revk/ESP32-Gyro/PCB/Gyro/README.md

# Gyro

These files are for use in [KiCad](https://www.kicad.org).

## Trademark

This is an open source project, but bear in mind you cannot sell boards bearing the Andrews & Arnold Ltd name, the A&A logo, the registered trademark AJK logo, or the GS1 allocated EANs assigned to Andrews & Arnold Ltd.

## Images

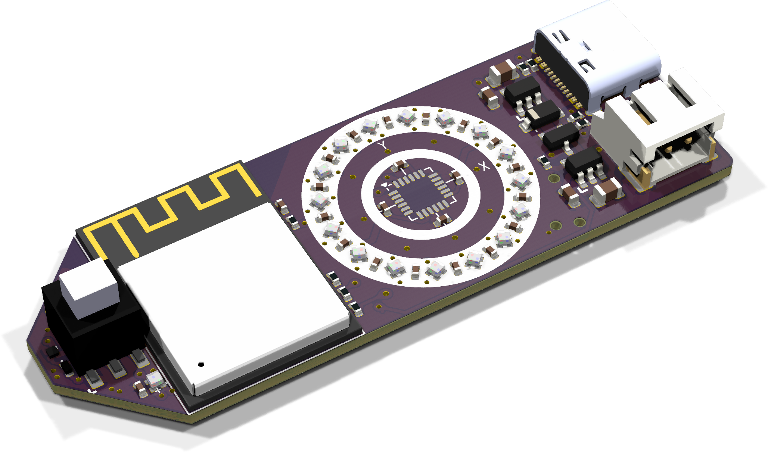
[picture p1: PCB/Gyro/Gyro.png]
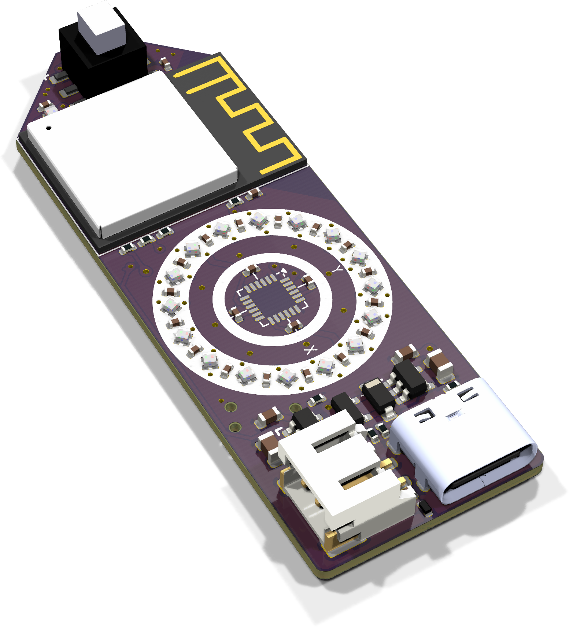
[picture p2: PCB/Gyro/Gyro-90.png]
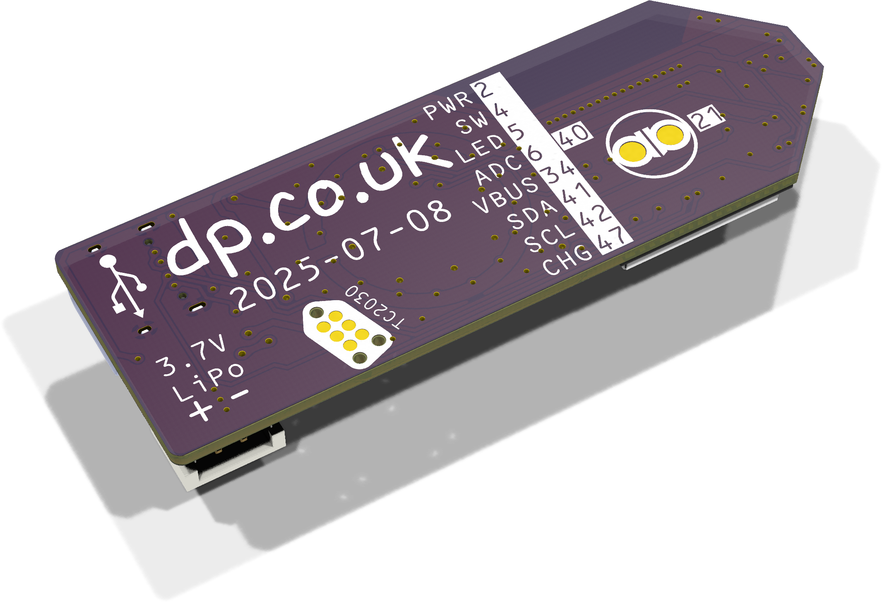
[picture p3: PCB/Gyro/Gyro-bottom.png]

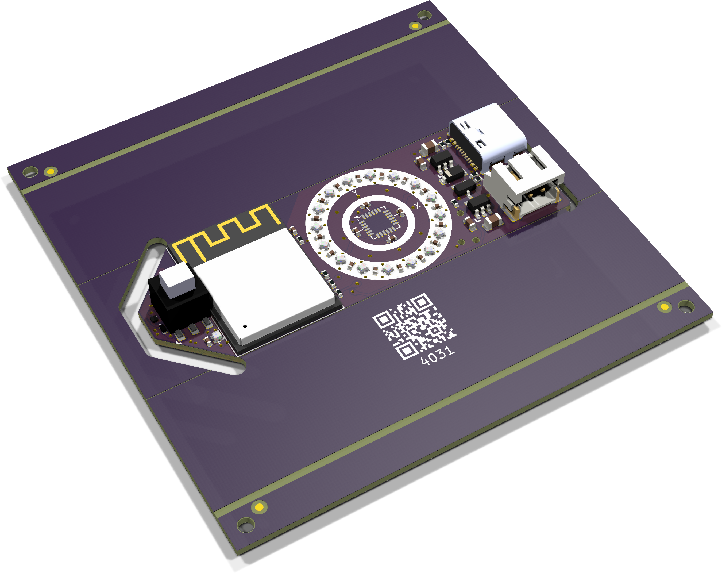
[picture p4: PCB/Gyro/Gyro-panel.png]
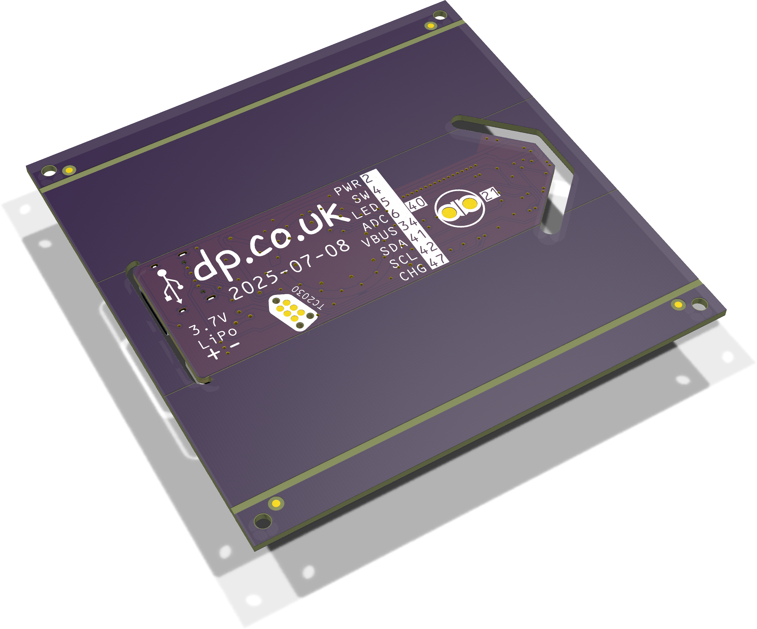
[picture p5: PCB/Gyro/Gyro-panel-bottom.png]


*Auto generated 2025-07-08T09:44:21*
