revk/ESP32-Gyro/PCB/Gyro/Gyro.stl

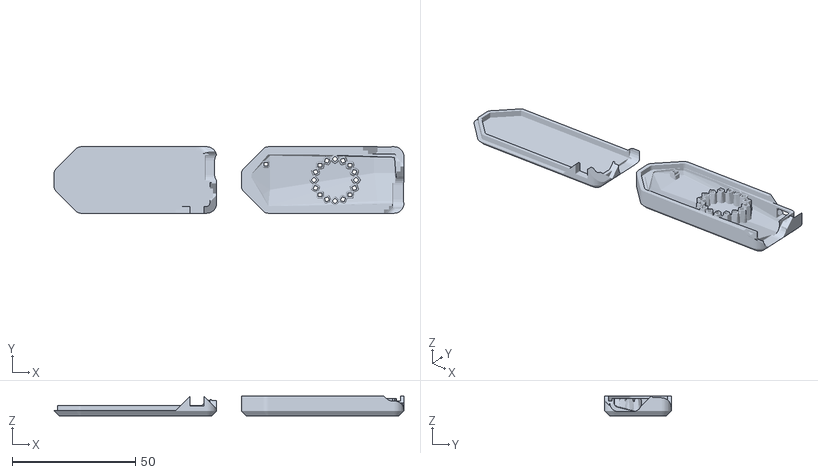
[picture p6: CAD file, 2025-07-08]
PCB/Gyro/Gyro.stl
142.0 x 27.0 x 8.00
