revk/ESP32-Gyro/PCB/Gyro/Gyro.kicad_pcb

## KiCad design PCB/Gyro/Gyro.kicad_pcb (2025-07-08)

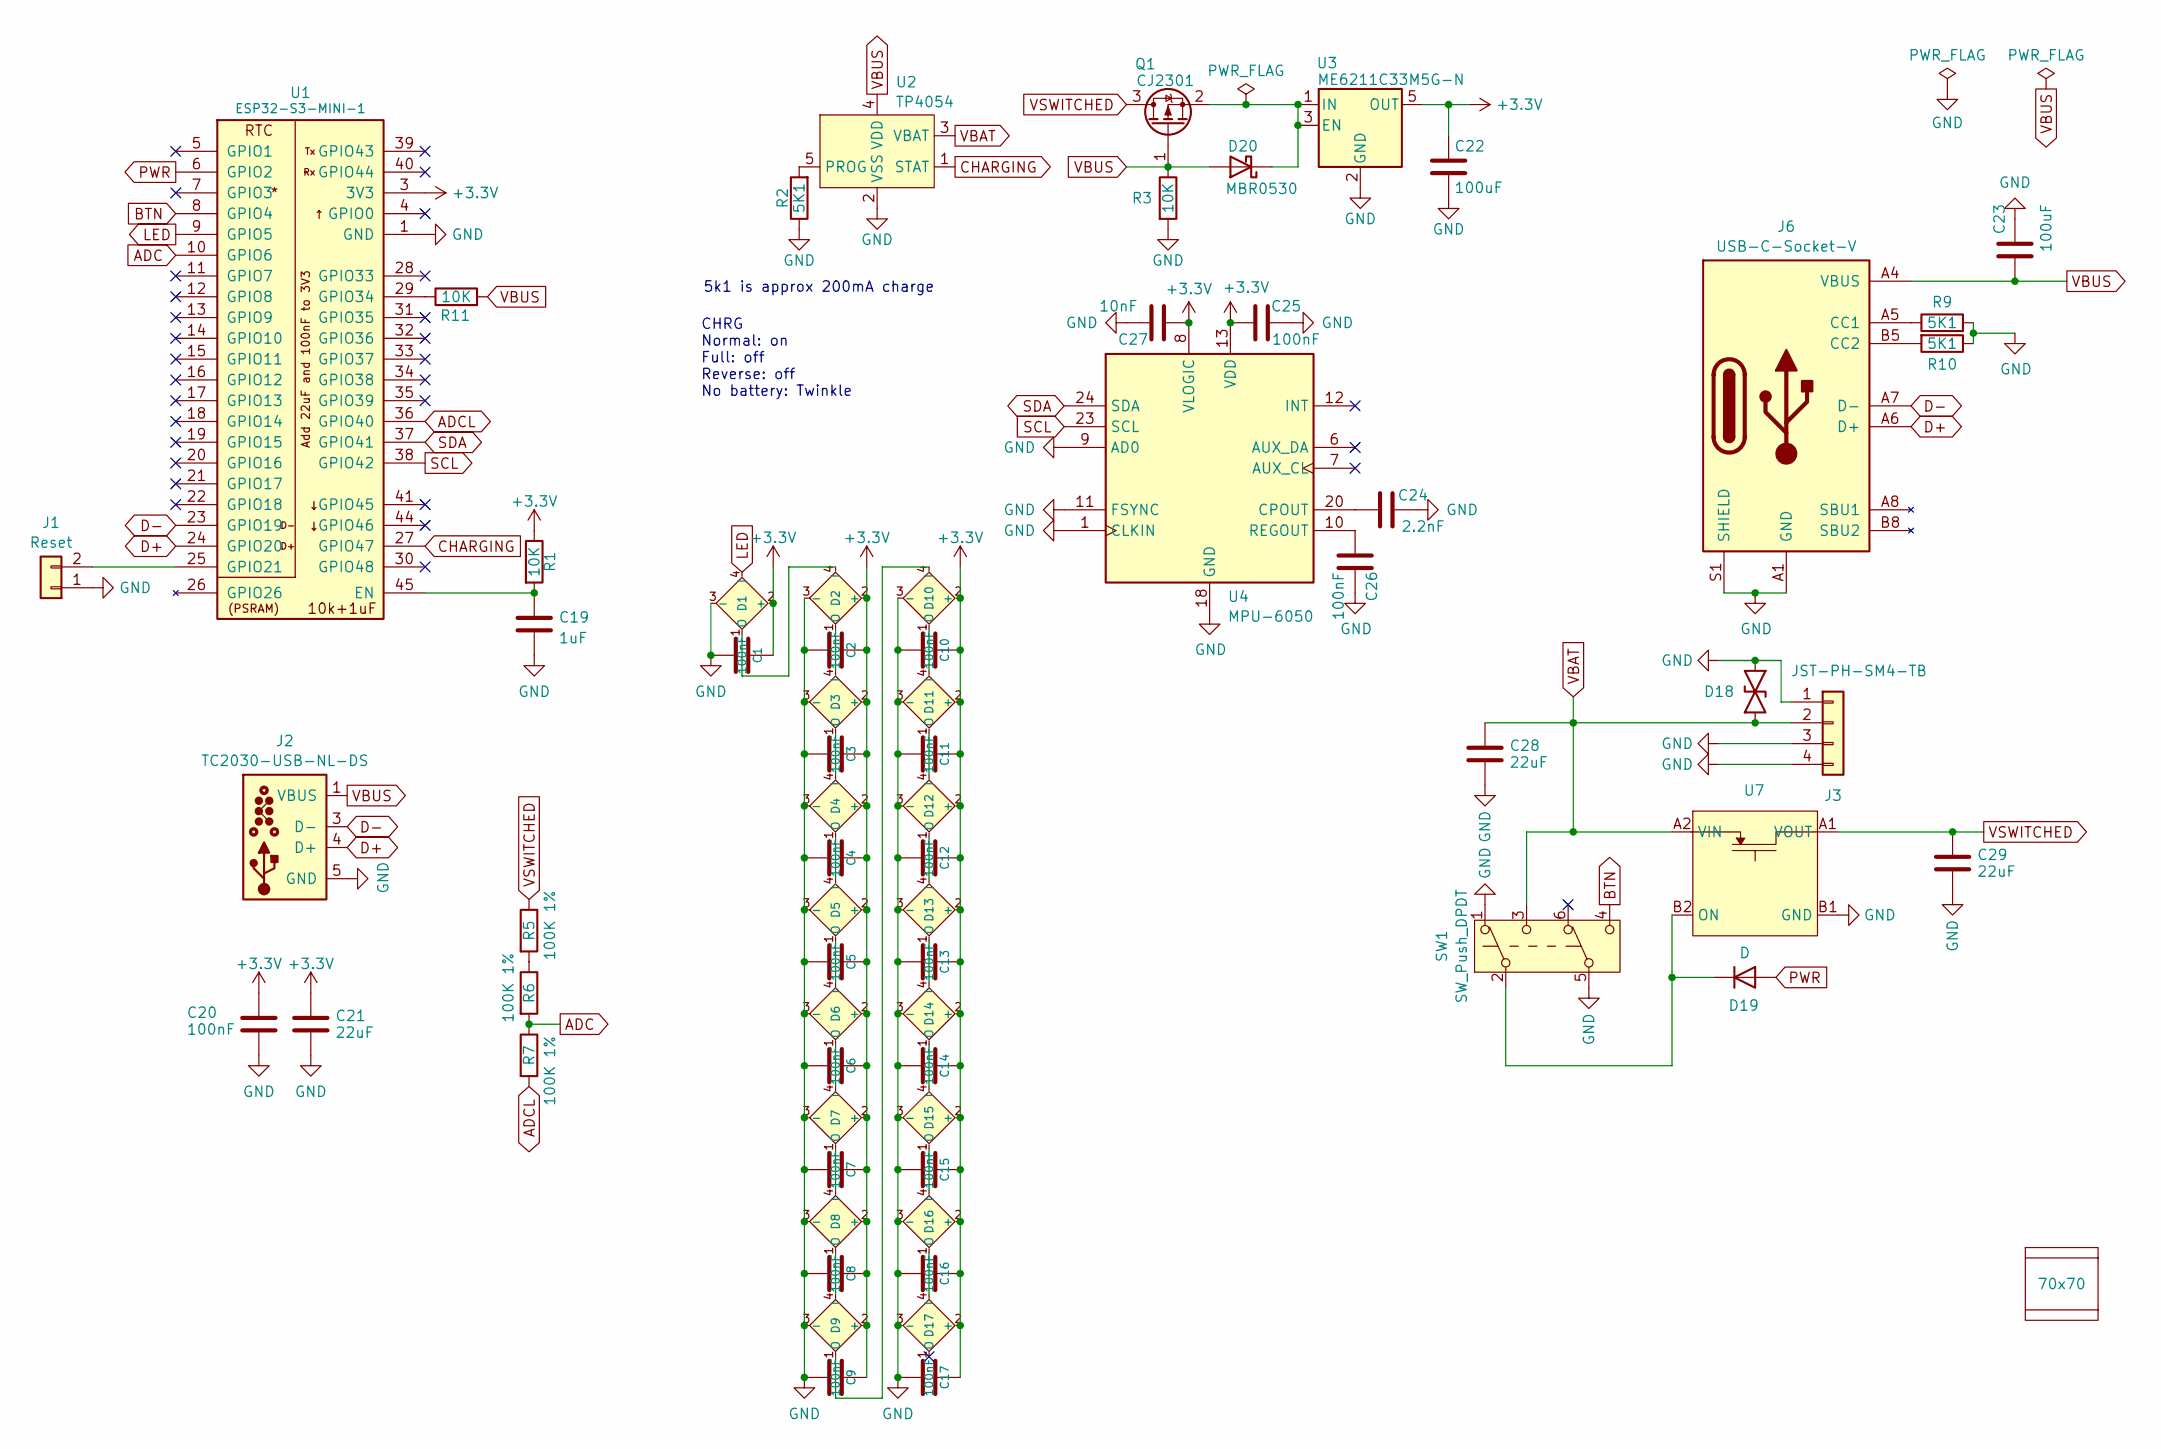
[picture p7: schematic Gyro.kicad_sch]

Parts:
C1, C2, C3, C4, C5, C6, C7, C8, C9, C10, C11, C12, C13, C14, C15, C16, C17, C20, C25, C26: 100nF; C_0402
C19: 1uF; C_0402
C21, C28, C29: 22uF; C_0603
C22, C23: 100uF; C_0805; MPN C141660
C24: 2.2nF; C_0402
C27: 10nF; C_0402
D1, D2, D3, D4, D5, D6, D7, D8, D9, D10, D11, D12, D13, D14, D15, D16, D17: XL-1010RGBC-WS2812B; SMD1010; MPN C5349953
D18: DFN1006-2L; MPN C5137770
D19: D; D_0402; MPN C28642302
D20: MBR0530; D_SOD-123; MPN C5204746
J1: Reset; AA-Pad
J2: TC2030-USB-NL-DS; Tag-Connect_TC2030-IDC-NL_2x03_P1.27mm_Vertical
J3: JST-PH-SM4-TB; JST_PH_S2B-PH-SM4-TB_1x02-1MP_P2.00mm_Horizontal; MPN C295747
J6: USB-C-Socket-V; USB-C-Socket-H; MPN C709357
PCB1: 70x70; PCB7070
Q1: CJ2301; SOT-23; MPN C8547
R1, R3, R11: 10K; R_0402; MPN C25744
R2, R9, R10: 5K1; R_0402; MPN C25905
R5, R6, R7: 100K 1%; R_0402; MPN C5139597
SW1: SW_Push_DPDT; MPN C2911139
U1: ESP32-S3-MINI-1; MPN C3013941
U2: TP4054; SOT-23-5; MPN C668215
U3: ME6211C33M5G-N; SOT-23-5; MPN C82942
U4: MPU-6050; InvenSense_QFN-24_4x4mm_P0.5mm; MPN C24112
U7: WCSP-4-0.78x0.78; MPN C2655476
V1, V2: VCUT70N

Connections:
+3.3V: C1.1, C2.1, C3.1, C4.1, C5.1, C6.1, C7.1, C8.1, C9.1, C10.1, C11.1, C12.1, C13.1, C14.1, C15.1, C16.1, C17.1, C20.1, C21.1, C22.1, C25.1, C27.1, D1.2 (+), D2.2 (+), D3.2 (+), D4.2 (+), D5.2 (+), D6.2 (+), D7.2 (+), D8.2 (+), D9.2 (+), D10.2 (+), D11.2 (+), D12.2 (+), D13.2 (+), D14.2 (+), D15.2 (+), D16.2 (+), D17.2 (+), R1.1, U1.3 (3V3), U3.5 (OUT), U4.8 (VLOGIC), U4.13 (VDD)
ADC: R6.2, R7.1, U1.10 (GPIO6)
ADCL: R7.2, U1.36 (GPIO40)
BTN: SW1.4 (C), U1.8 (GPIO4)
CHARGING: U1.27 (GPIO47), U2.1 (STAT)
D+: J2.4 (D+), J6.A6 (D+), J6.B6 (D+), U1.24 (GPIO20)
D-: J2.2 (NC), J2.3 (D-), J2.6 (NC), J6.A7 (D-), J6.B7 (D-), U1.23 (GPIO19)
GND: C1.2, C2.2, C3.2, C4.2, C5.2, C6.2, C7.2, C8.2, C9.2, C10.2, C11.2, C12.2, C13.2, C14.2, C15.2, C16.2, C17.2, C19.2, C20.2, C21.2, C22.2, C23.2, C24.2, C25.2, C26.2, C27.2, C28.2, C29.2, D1.3 (-), D2.3 (-), D3.3 (-), D4.3 (-), D5.3 (-), D6.3 (-), D7.3 (-), D8.3 (-), D9.3 (-), D10.3 (-), D11.3 (-), D12.3 (-), D13.3 (-), D14.3 (-), D15.3 (-), D16.3 (-), D17.3 (-), D18.1, J1.1, J2.5 (GND), J3.1, J3.3, J3.4, J6.A1 (GND), J6.A12 (GND), J6.B1 (GND), J6.B12 (GND), J6.S1 (SHIELD), R2.1, R3.2, R9.2, R10.1, SW1.1 (A), SW1.5 (B), U1.1 (GND), U1.2 (GND), U1.42 (GND), U1.43 (GND), U1.46 (GND), U1.47 (GND), U1.48 (GND), U1.49 (GND), U1.50 (GND), U1.51 (GND), U1.52 (GND), U1.53 (GND), U1.54 (GND), U1.55 (GND), U1.56 (GND), U1.57 (GND), U1.58 (GND), U1.59 (GND), U1.60 (GND), U1.61 (GND), U1.62 (GND), U1.63 (GND), U1.64 (GND), U1.65 (GND), U2.2 (VSS), U3.2 (GND), U4.1 (CLKIN), U4.9 (AD0), U4.11 (FSYNC), U4.18 (GND), U7.B1 (GND)
LED: D1.4 (I), U1.9 (GPIO5)
unnamed: D1.1 (O), D2.4 (I)
unnamed: D2.1 (O), D3.4 (I)
unnamed: D3.1 (O), D4.4 (I)
unnamed: D4.1 (O), D5.4 (I)
unnamed: D5.1 (O), D6.4 (I)
unnamed: D6.1 (O), D7.4 (I)
unnamed: D7.1 (O), D8.4 (I)
unnamed: D8.1 (O), D9.4 (I)
unnamed: D9.1 (O), D10.4 (I)
unnamed: D10.1 (O), D11.4 (I)
unnamed: D11.1 (O), D12.4 (I)
unnamed: D12.1 (O), D13.4 (I)
unnamed: D13.1 (O), D14.4 (I)
unnamed: D14.1 (O), D15.4 (I)
unnamed: D15.1 (O), D16.4 (I)
unnamed: D16.1 (O), D17.4 (I)
unnamed: D19.1 (K), SW1.2 (B), U7.B2 (ON)
unnamed: D20.1 (K), Q1.2 (S), U3.1 (IN), U3.3 (EN)
unnamed: J1.2, U1.25 (GPIO21)
unnamed: J6.A5 (CC1), R9.1
unnamed: J6.B5 (CC2), R10.2
unnamed: R5.2, R6.1
unnamed: C19.1, R1.2, U1.45 (EN)
unnamed: R11.1, U1.29 (GPIO34)
unnamed: R2.2, U2.5 (PROG)
unnamed: C24.1, U4.20 (CPOUT)
unnamed: C26.1, U4.10 (REGOUT)
PWR: D19.2 (A), U1.6 (GPIO2)
SCL: U1.38 (GPIO42), U4.23 (SCL)
SDA: U1.37 (GPIO41), U4.24 (SDA)
VBAT: C28.1, D18.2, J3.2, SW1.3 (C), U2.3 (VBAT), U7.A2 (VIN)
VBUS: C23.1, D20.2 (A), J2.1 (VBUS), J6.A4 (VBUS), J6.A9 (VBUS), J6.B4 (VBUS), J6.B9 (VBUS), Q1.1 (G), R3.1, R11.2, U2.4 (VDD)
VSWITCHED: C29.1, Q1.3 (D), R5.1, U7.A1 (VOUT)

Notes on the sheet:
5k1 is approx 200mA charge
CHRG Normal: on Full: off Reverse: off No battery: Twinkle

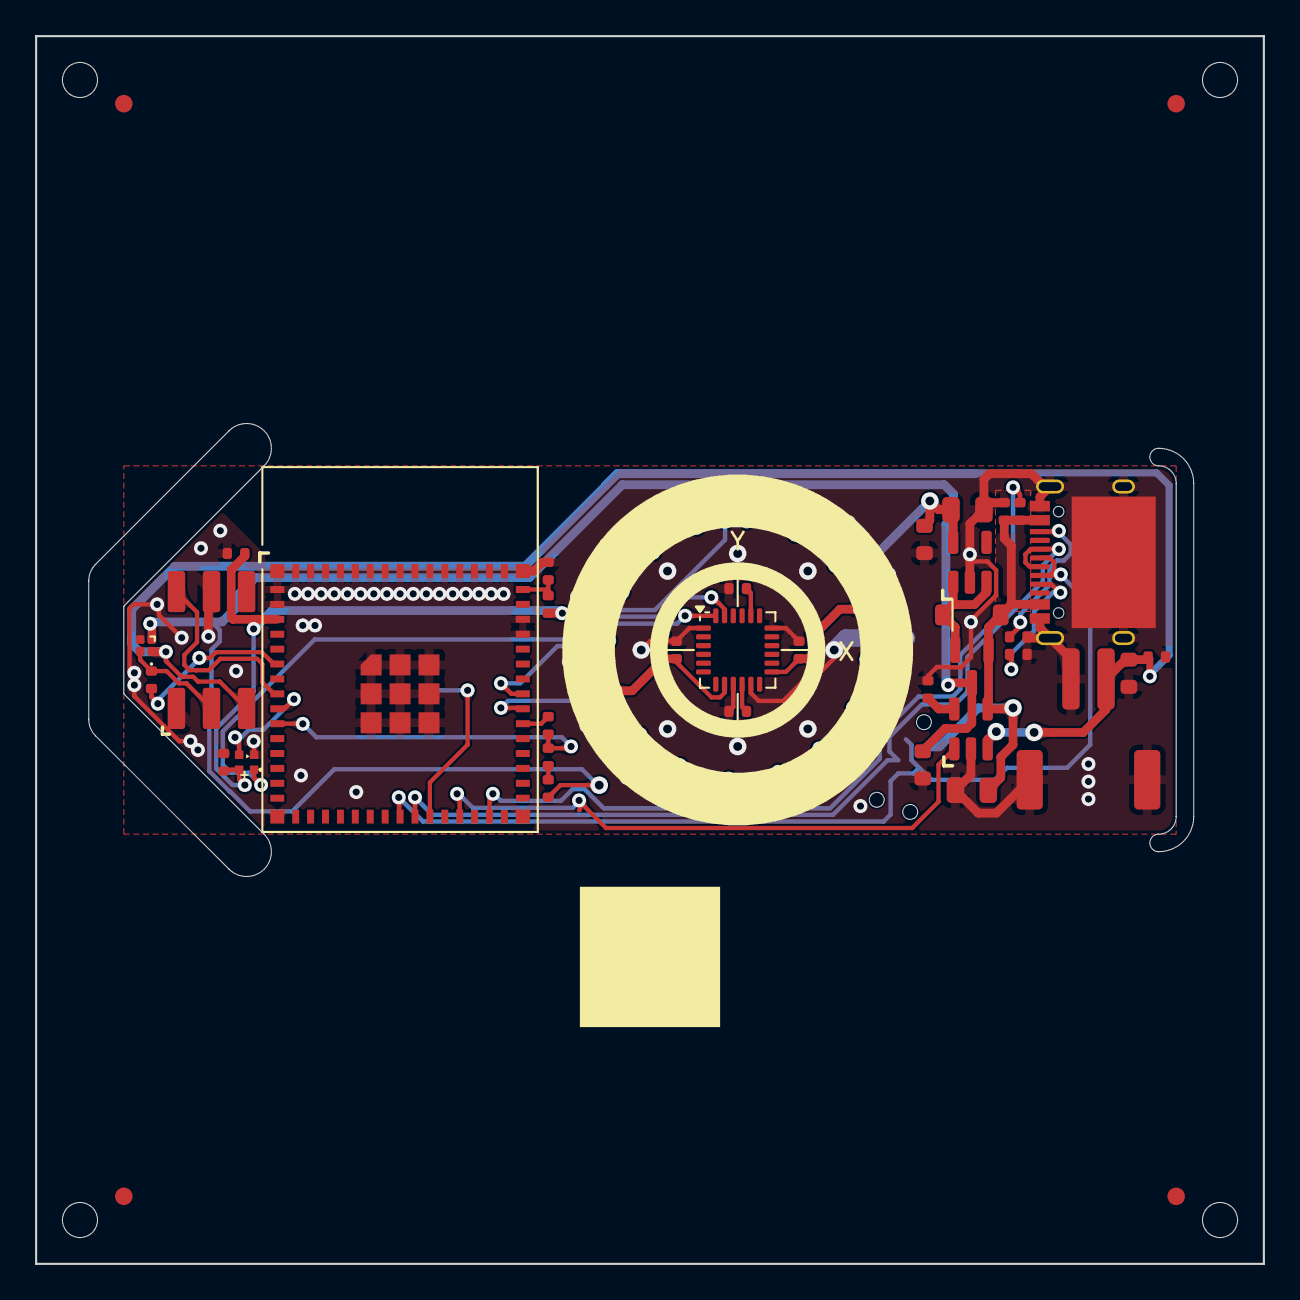
[picture p8: board Gyro.kicad_pcb from above]

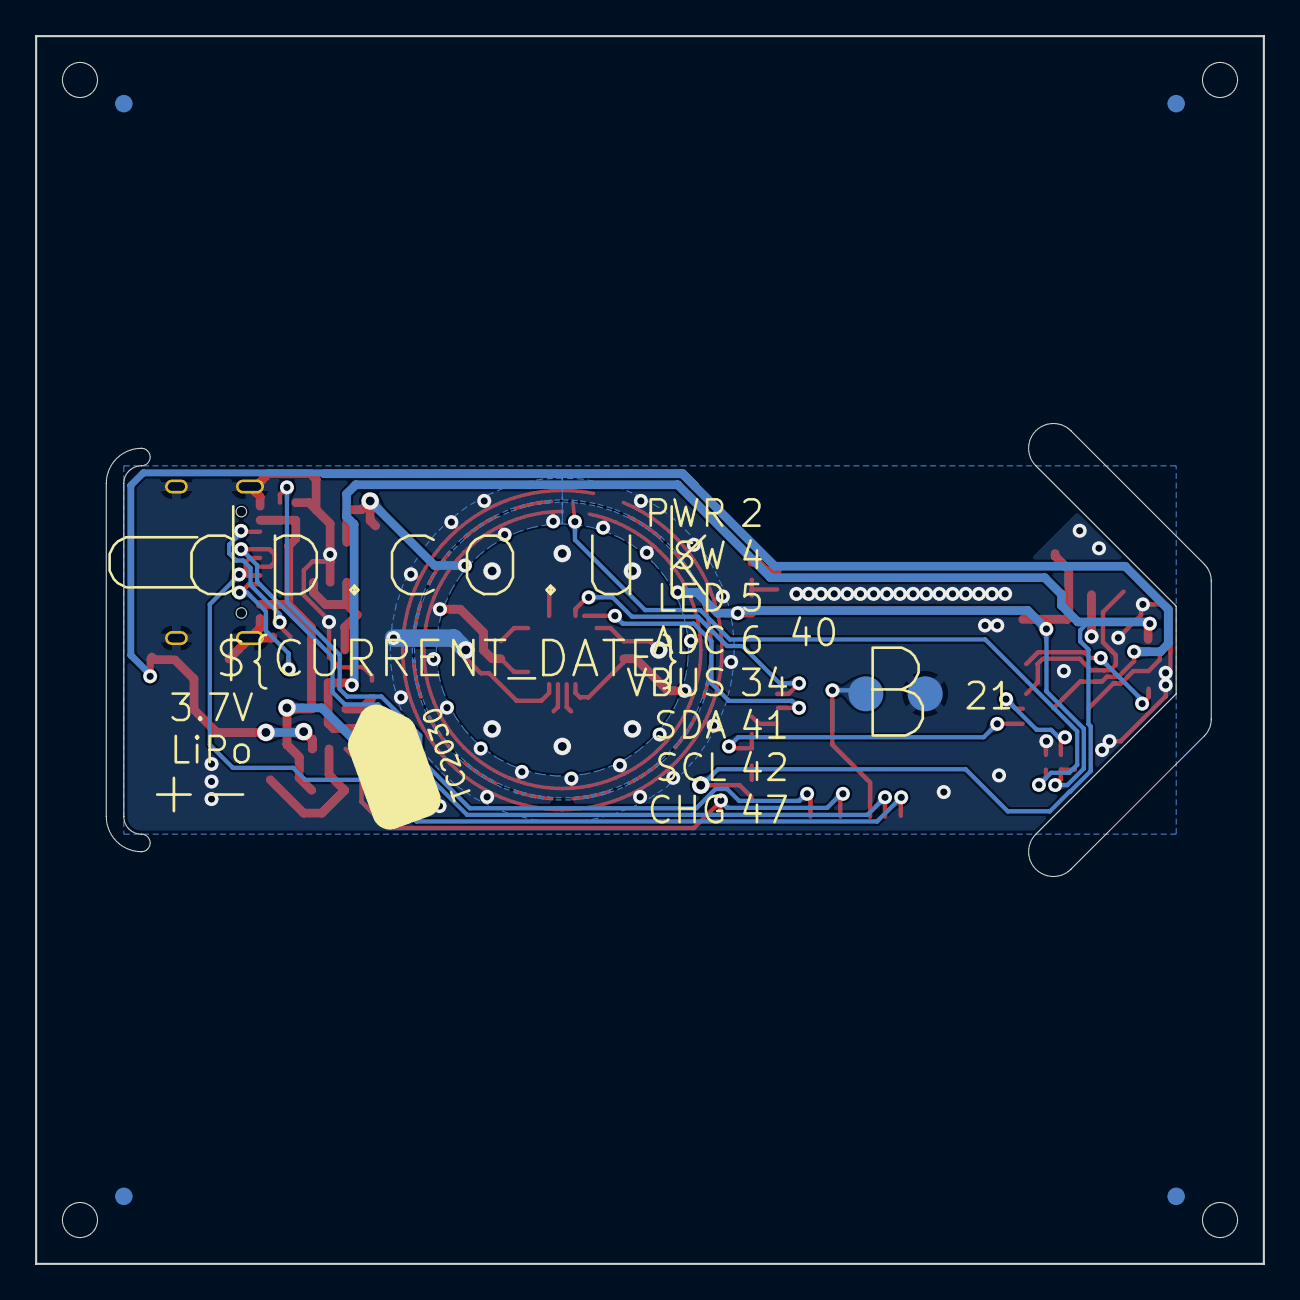
[picture p9: board Gyro.kicad_pcb from below]

Board: 2 copper layers, 70.0 x 70.0 mm, 71 parts (3 on the bottom side), 42 nets.
