revk/ESP32-Gyro/(commit log)

2025-06-17 Started PCb
    [Gyro.kicad_pcb, Gyro.kicad_sch, Gyro.scad]
2025-06-17 As ordered
    [Gyro.kicad_pcb, Gyro.kicad_sch, Gyro.scad, Gyro.stl, bom.csv, designators.csv, positions.csv]
2025-06-17 Slioght tidy
    [Gyro.kicad_pcb]
2025-06-18 V-cuts fix
    [Gyro.kicad_pcb]
2025-06-21 Try the power distribution switches.
    [Gyro.kicad_pcb, Gyro.kicad_sch, bom.csv, designators.csv, positions.csv]
2025-06-22 Tweak SS
    [Gyro.kicad_pcb]
2025-06-26 Basic level on LEDs
2025-06-29 Battery and button
2025-06-29 New board
2025-06-30 Adjust battery and report G
2025-06-30 power off MPU-6050
2025-06-30 3.1V base
2025-07-07 New boards
2025-07-08 Power off
2025-07-08 New power control
    [Gyro.kicad_pcb, Gyro.kicad_sch, Gyro.scad, Gyro.stl, bom.csv, designators.csv, positions.csv]
